cramsvik/CRA2-D2/README.md

# CRA2-D2
Code for controlling Dome lights in R2-D2. STLs and instructions for making the lights..

Instructions in the PDF will be the most updated ones; the text file is only a draft that I didn't remove.

All files are used at your own risk.
