cramsvik/CRA2-D2/STL/PSI_insert_Front_v3.stl

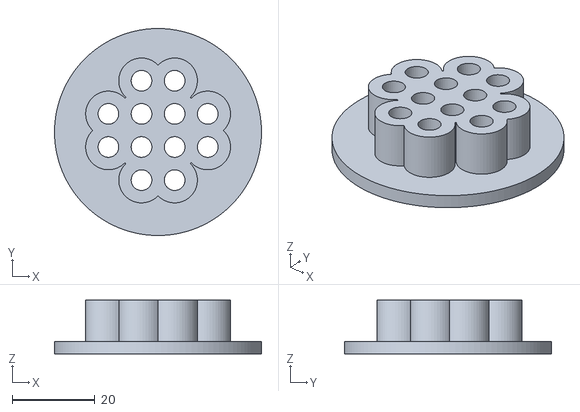
[picture p1: CAD file, 2020-03-26]
STL/PSI_insert_Front_v3.stl
50.0 x 50.0 x 13.0
