cramsvik/CRA2-D2/STL/PSI_insert_Back_v3.stl

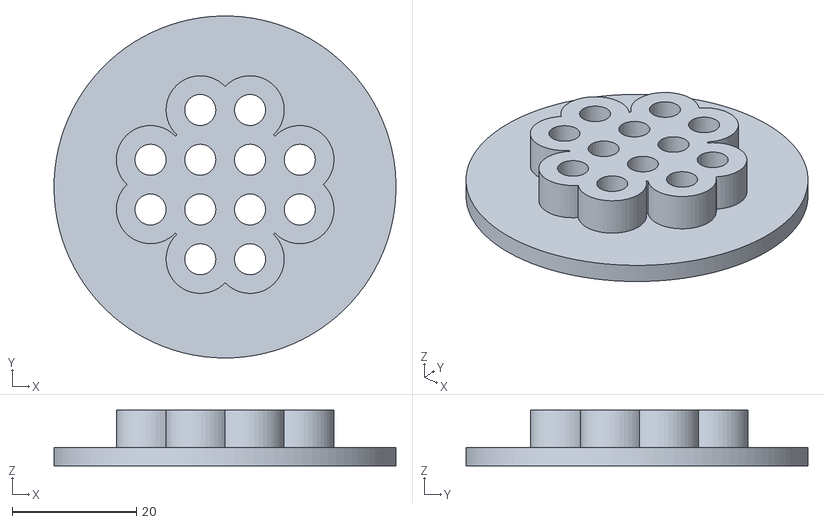
[picture p2: CAD file, 2020-03-26]
STL/PSI_insert_Back_v3.stl
55.0 x 55.0 x 9.00
