cramsvik/CRA2-D2/STL/Bezel_Fiberoptics_large_front_v3.stl

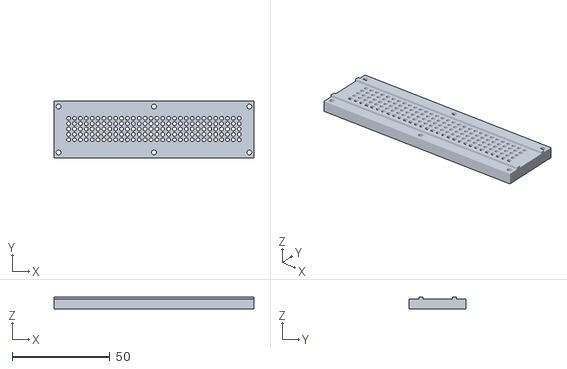
[picture p3: CAD file, 2020-03-26]
STL/Bezel_Fiberoptics_large_front_v3.stl
102.5 x 29.0 x 6.00
