cramsvik/CRA2-D2/STL/Bezel_Fiberoptics_small_front_v3__2x.stl

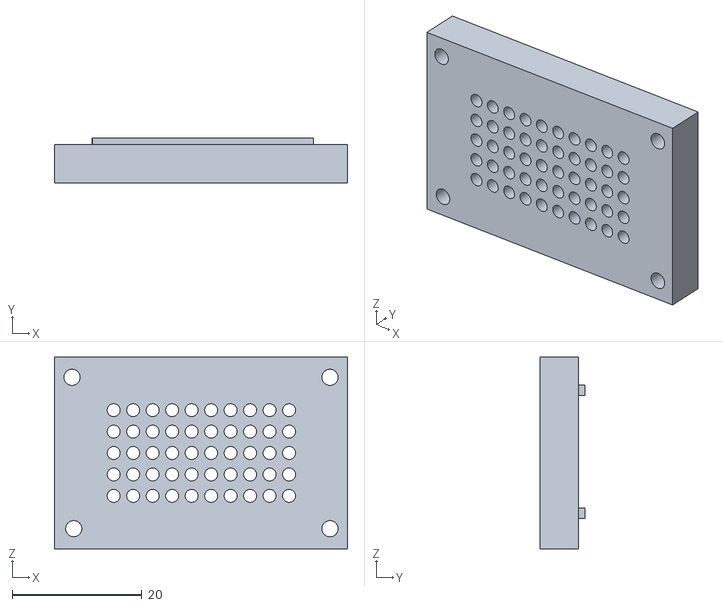
[picture p4: CAD file, 2020-03-26]
STL/Bezel_Fiberoptics_small_front_v3__2x.stl
45.1 x 7.00 x 29.5
