cramsvik/CRA2-D2/STL/Bezel_Fiberoptics_LED_base_v3__5x.stl

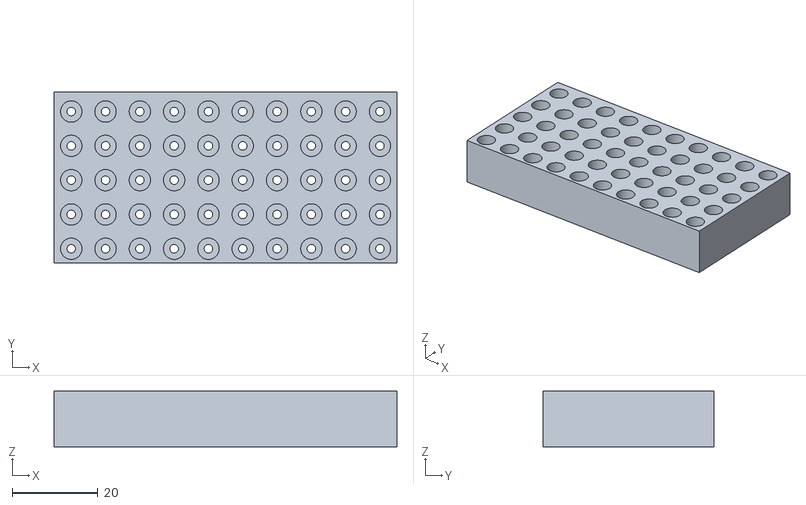
[picture p5: CAD file, 2020-03-26]
STL/Bezel_Fiberoptics_LED_base_v3__5x.stl
80.0 x 40.0 x 13.0
