cramsvik/CRA2-D2/(commit log)

2020-03-18 Initial add of current code
2020-03-26 renamed stl files, updated arduino code
    [Bezel_Fiberoptics_LED_base_v3__5x.stl, Bezel_Fiberoptics_large_front_v3.stl, Bezel_Fiberoptics_small_front_v3__2x.stl, PSI_insert_Back_v3.stl, PSI_insert_Front_v3.stl]
